AsynchronousConfession/smoke-alarm/(commit log)

2026-10-08 家庭室内多节点烟雾报警系统 v1.0
    三路 CH573F 蓝牙气敏节点 + 双路线 ESP32 网关 + 云端网页大屏。
    节点本地判警（断网照响），数据经 BLE / MQTT 上云，网页可实时查看并下发指令。
    - node_ch573f/ CH573F 节点固件：ADC 采样、自适应基线、迟滞报警、蜂鸣器、下行命令
    - gateway_esp32s3/ 网关 A（无外设版）：BLE 主机 + WiFi/MQTT 上云（基线版本，协议以它为准）
    - cyd_gateway/ 网关 B（2.8 寸触摸屏版）：本地大屏、四页签界面、一键标定、探头自检、报警弹窗
    - server/ 云端：Mosquitto + Python 后端（REST/SSE/SQLite）+ 原生 JS 网页（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
    [partitions.csv]
2026-10-08 添加 MIT 许可证，并同步 README 的许可说明与许可范围
    - 新增 LICENSE（MIT，Copyright (c) 2026 AsynchronousConfession）
    - README：仓库结构补上 LICENSE；许可一节明确'只覆盖作者自写代码'，
    并说明沁恒 SDK / LVGL / ECharts 等第三方组件不在本许可范围内；
    补充安全类项目的免责提示
